IJeffray/IanS_ide_podule-16bit/PCB/README.md

# ide podule 16bit

These are the KiCad (version 8) files for the 16-bit ide podule.
