IJeffray/IanS_ide_podule-16bit/PCB/Altium/ide_podule-16bit_long_cf_backplate.STEP

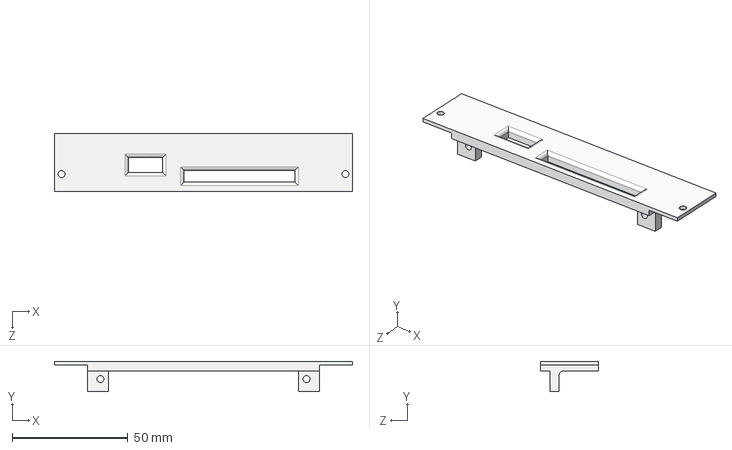
[picture p2: CAD file, 2026-10-07]
PCB/Altium/ide_podule-16bit_long_cf_backplate.STEP
128.6 x 13.1 x 25.0 mm
