IJeffray/IanS_ide_podule-16bit/(list of files, cad)

Other CAD files:
PCB/Altium/ide_podule-16bit_long_cf_backplate.SLDPRT
