IJeffray/IanS_ide_podule-16bit/Schematic.pdf

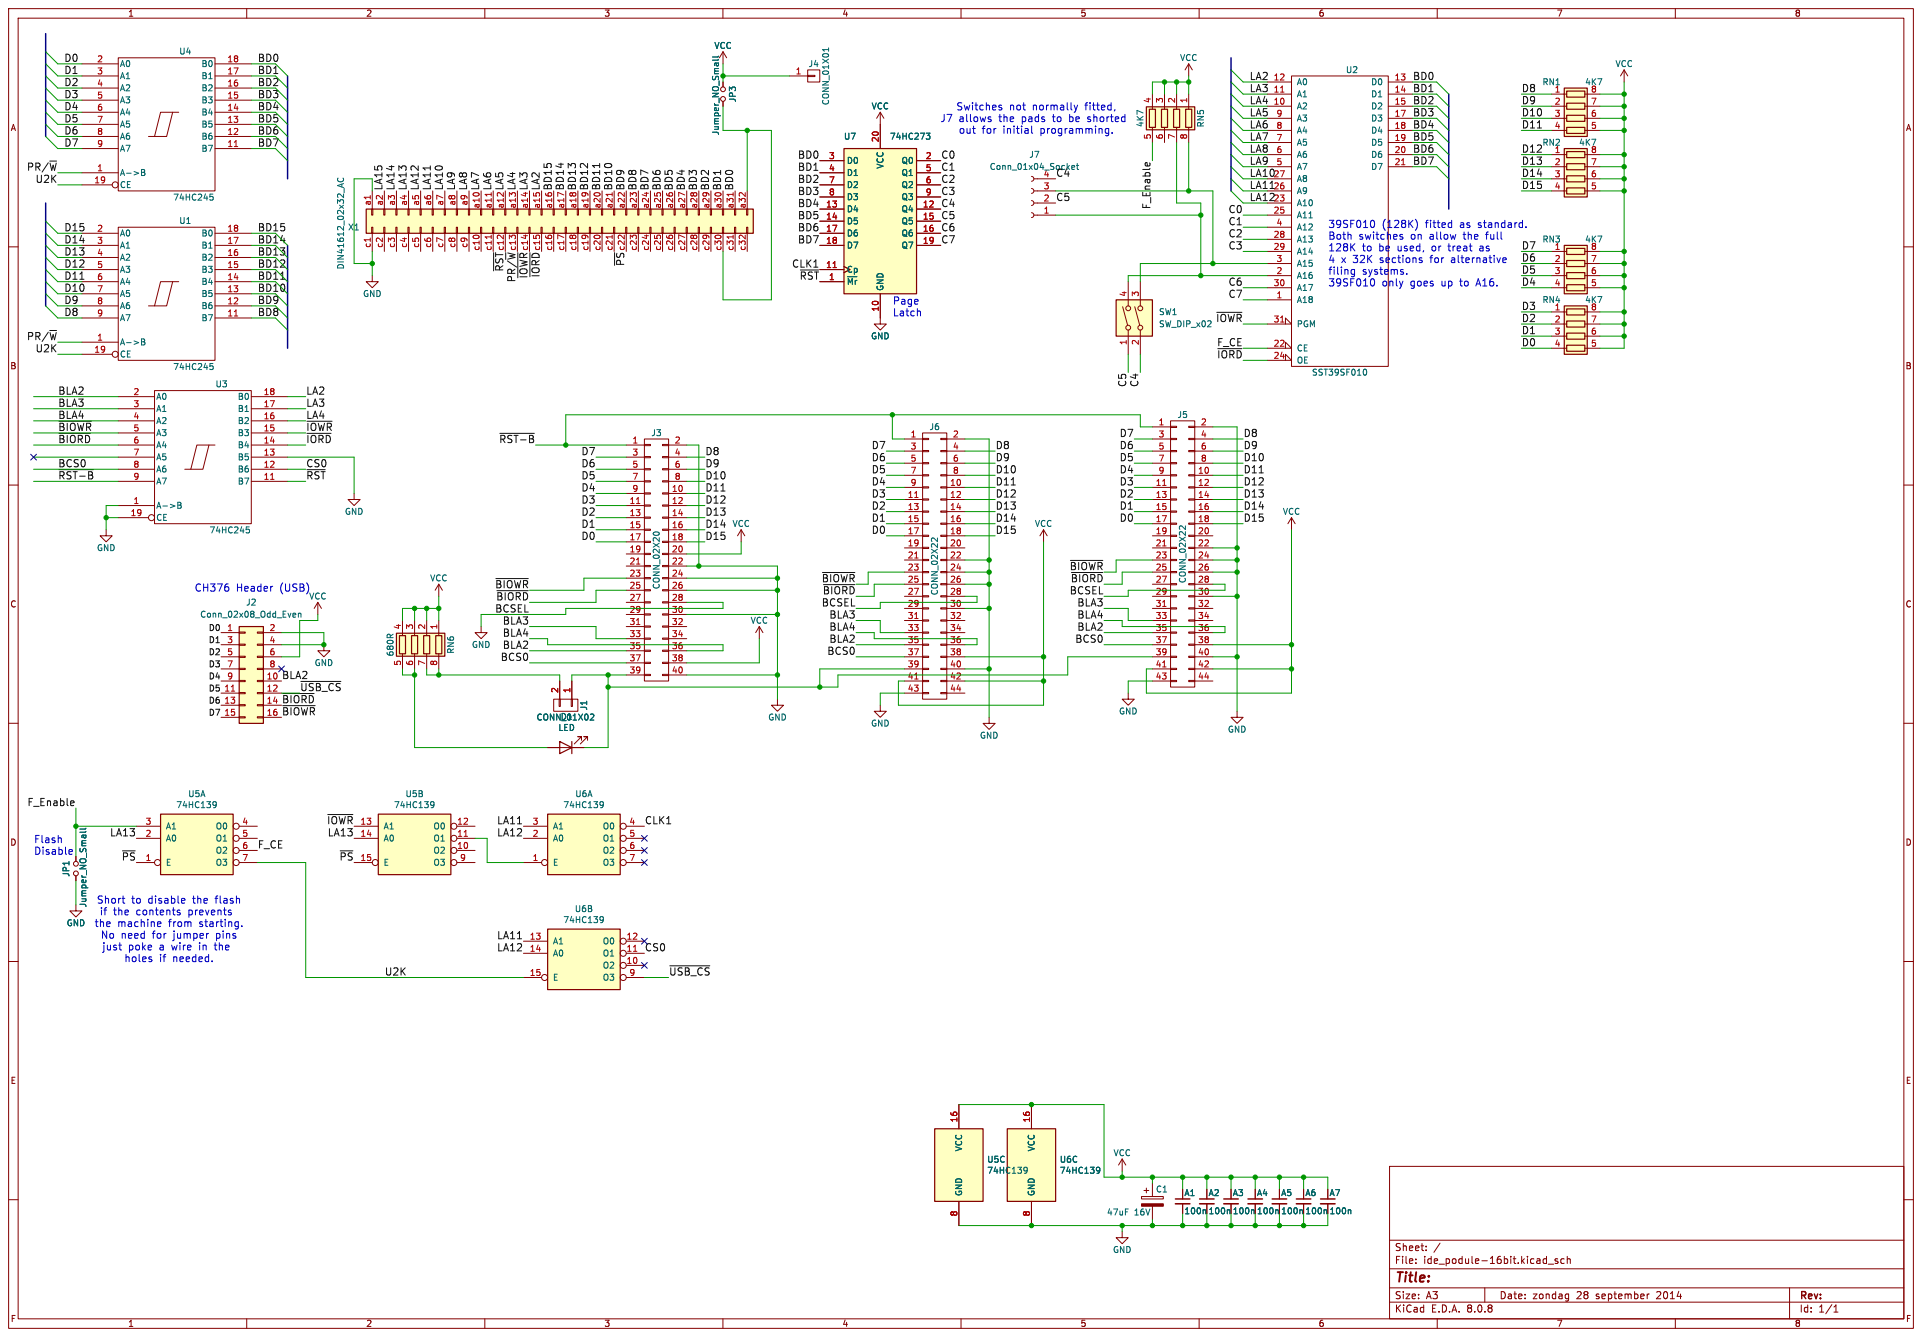
[picture p3: page 1]

39SF010 (128K) fitted as standard. Both switches on allow the full 128K to be used, or treat as 4 x 32K sections for alternative

Short to disable the flash
the machine from starting. No need for jumper pins

just poke a wire in the
holes if needed.

Id: 1/1 Title: File: ide_podule-16bit.kicad_sch Sheet: /
