IJeffray/IanS_ide_podule-16bit/(list of files, drawings)

Other design files:
PCB/Altium/ide_podule-16bit.PcbDoc
PCB/Altium/ide_podule-16bit.PrjPcb
PCB/Altium/ide_podule-16bit.SchDoc
PCB/Altium/ide_podule-16bit.SchLib
PCB/Altium/ide_podule-16bit_long.PcbDoc
