IJeffray/IanS_ide_podule-16bit/PCB/ide_podule-16bit.kicad_pcb

## KiCad design PCB/ide_podule-16bit.kicad_pcb (2026-04-19)

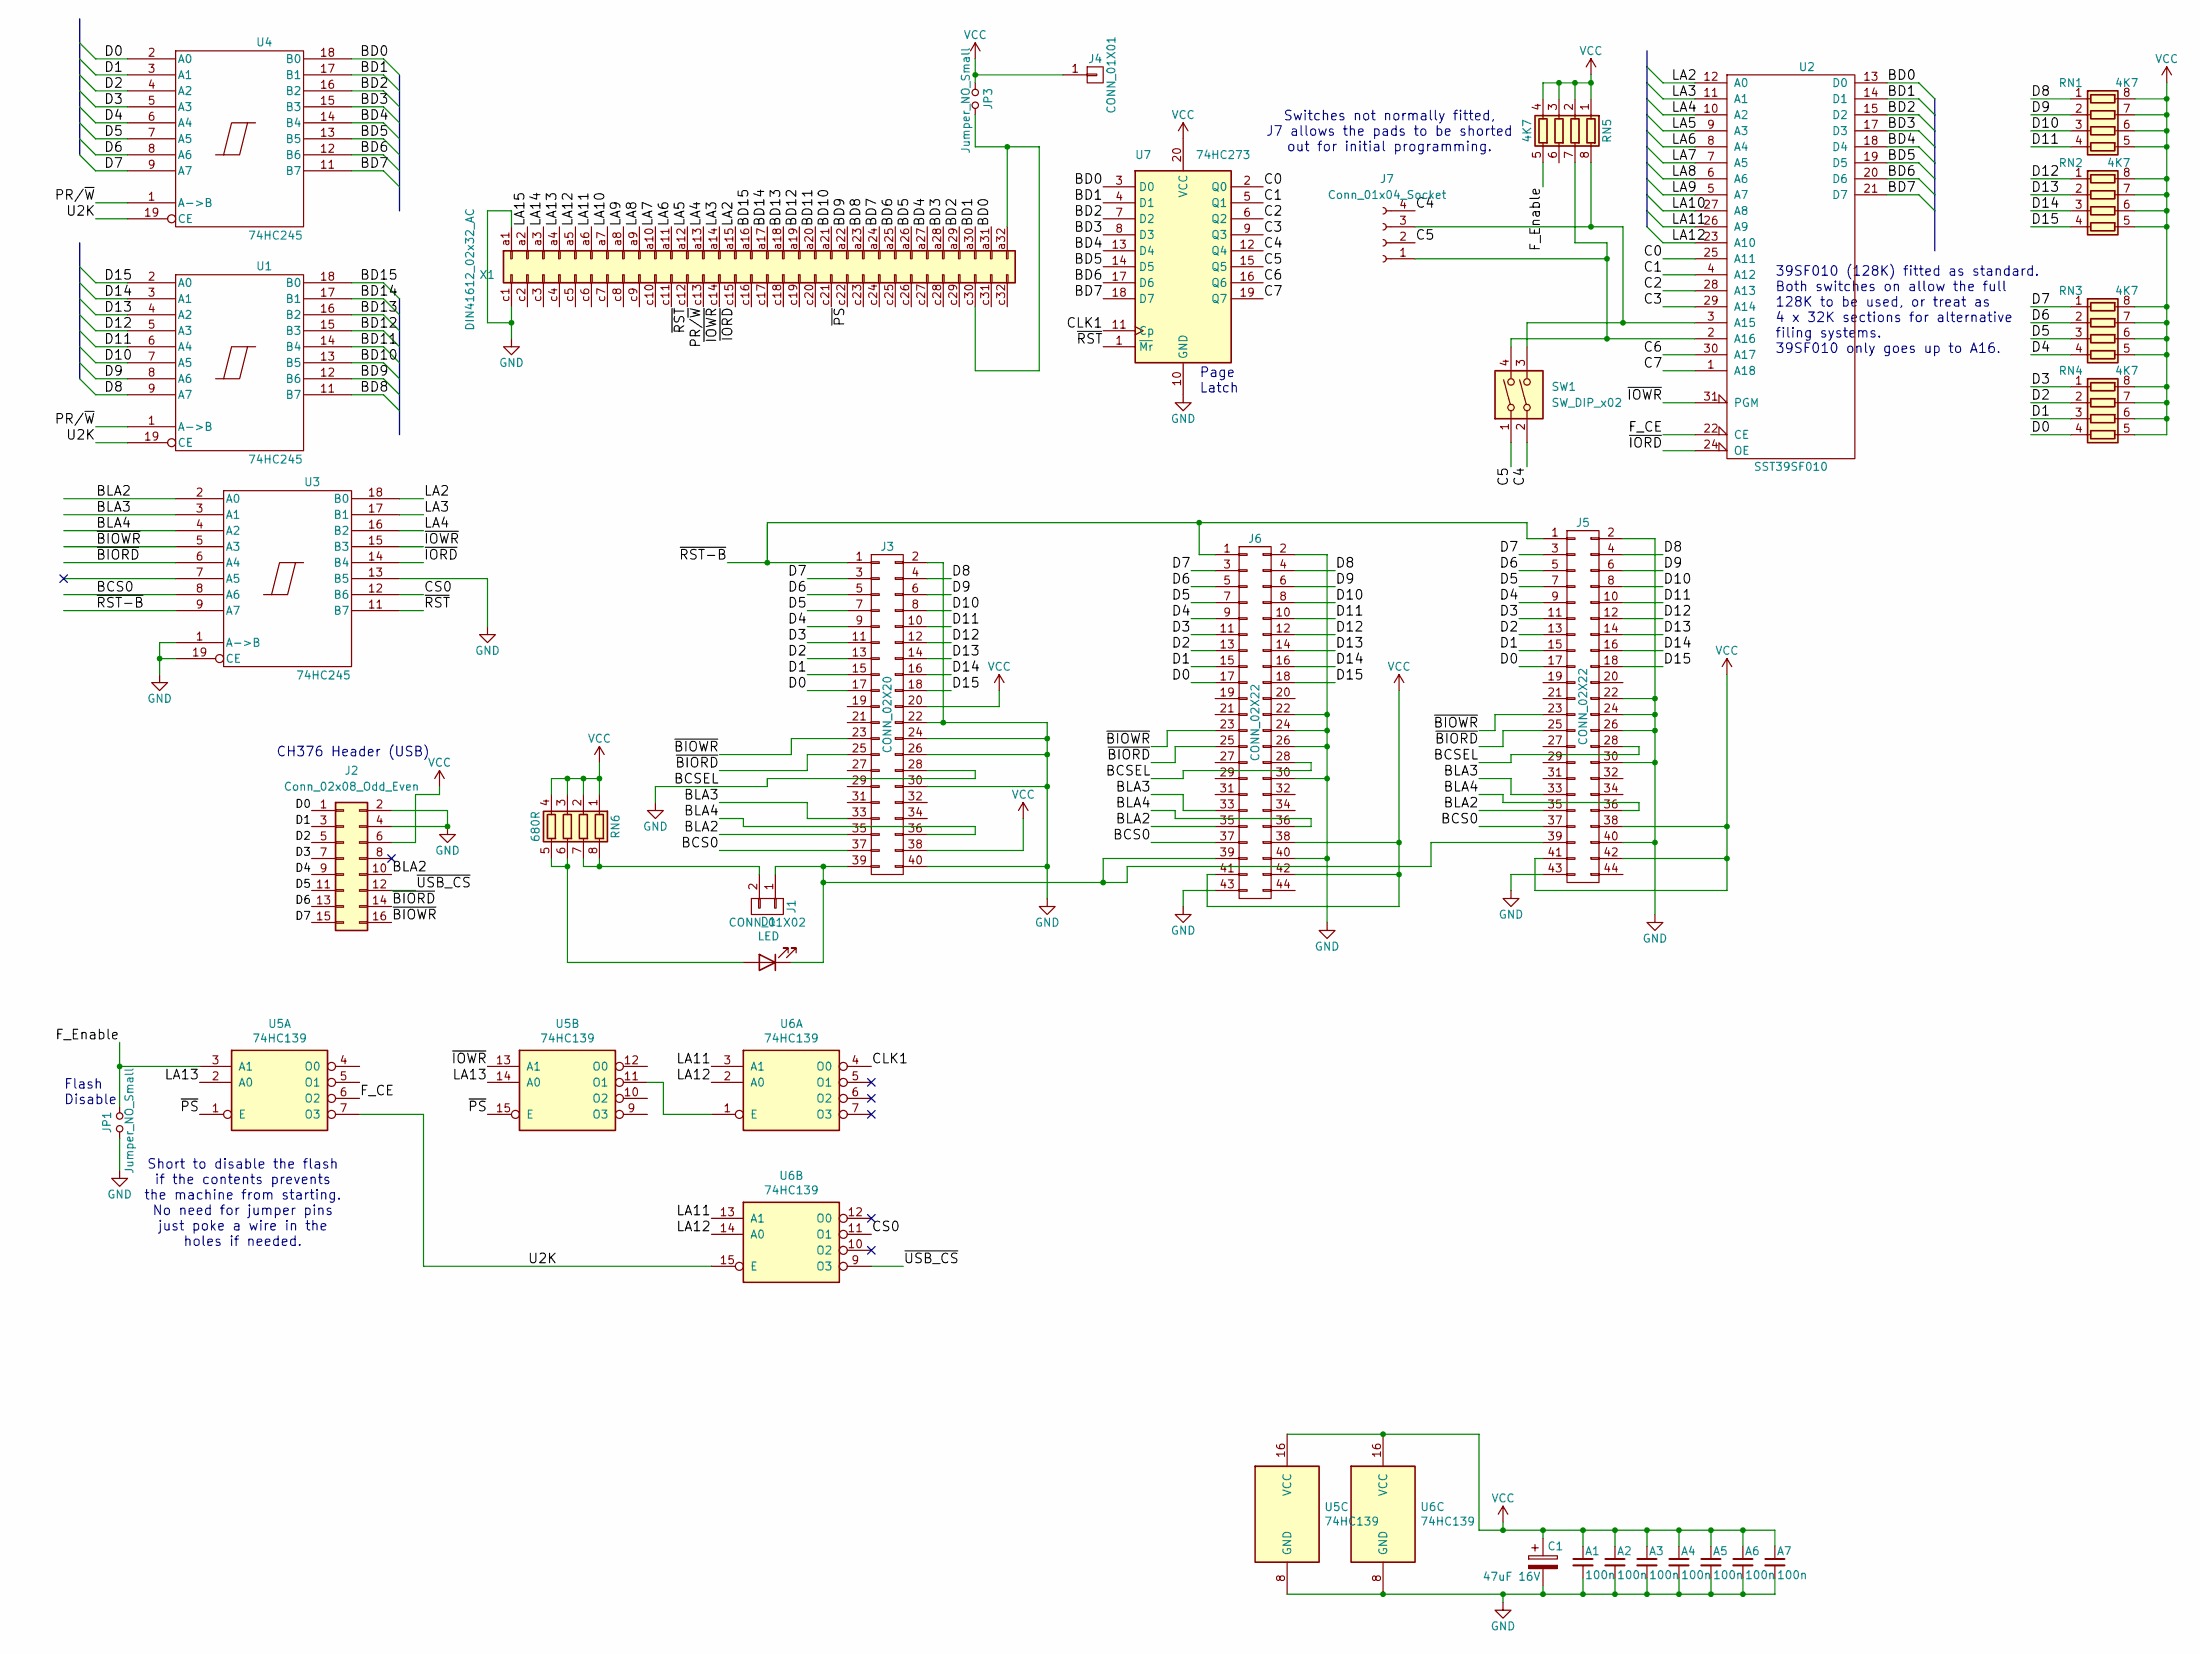
[picture p4: schematic ide_podule-16bit.kicad_sch]

Parts:
A1, A2, A3, A4, A5, A6, A7: 100n; C_1206_3216Metric_Pad1.33x1.80mm_HandSolder
C1: 47uF 16V; CP_Elec_6.3x5.8
D1: LED; LED_1206_3216Metric
J1: CONN_01X02; PinHeader_1x02_P2.54mm_Vertical
J2: Conn_02x08_Odd_Even; CH376-mod
J3: CONN_02X20; PinHeader_2x20_P2.54mm_Vertical
J4: CONN_01X01; SolderWirePad_2x_1-5mmDrill
J5: CONN_02X22; PinHeader_2x22_P2.00mm_Vertical
J6: CONN_02X22; IDE-edge-44pinC
J7: Conn_01x04_Socket; 4 way edge
JP1: Jumper_NO_Small; PinHeader_1x02_P2.54mm_Vertical
JP3: Jumper_NO_Small; PinHeader_2x01_P2.54mm_Vertical
RN1, RN2, RN3, RN4, RN5: 4K7; R_Array_Convex_4x0603
RN6: 680R; R_Array_Convex_4x0603
SW1: SW_DIP_x02; DIP-4_W7.62mm_Socket
U1, U3, U4: 74HC245; SOIC-20W_7.5x12.8mm_P1.27mm
U2: SST39SF010; PLCC-32_11.4x14.0mm_P1.27mm
U5, U6: 74HC139; STC_SOP-16_3.9x9.9mm_P1.27mm
U7: 74HC273; SOIC-20W_7.5x12.8mm_P1.27mm
X1: DIN41612_02x32_AC; DIN41612_C_2x32_Male_Horizontal_THT

Connections:
/BCS0: J3.37, J5.37, J6.37, U3.8 (A6)
/BD0: U2.13 (D0), U4.18 (B0), U7.3 (D0), X1.a31
/BD1: U2.14 (D1), U4.17 (B1), U7.4 (D1), X1.a30
/BD2: U2.15 (D2), U4.16 (B2), U7.7 (D2), X1.a29
/BD3: U2.17 (D3), U4.15 (B3), U7.8 (D3), X1.a28
/BD4: U2.18 (D4), U4.14 (B4), U7.13 (D4), X1.a27
/BD5: U2.19 (D5), U4.13 (B5), U7.14 (D5), X1.a26
/BD6: U2.20 (D6), U4.12 (B6), U7.17 (D6), X1.a25
/BD7: U2.21 (D7), U4.11 (B7), U7.18 (D7), X1.a24
/BD8: U1.11 (B7), X1.a23
/BD9: U1.12 (B6), X1.a22
/BD10: U1.13 (B5), X1.a21
/BD11: U1.14 (B4), X1.a20
/BD12: U1.15 (B3), X1.a19
/BD13: U1.16 (B2), X1.a18
/BD14: U1.17 (B1), X1.a17
/BD15: U1.18 (B0), X1.a16
/BLA2: J2.10, J3.35, J5.35, J6.35, U3.2 (A0)
/BLA3: J3.33, J5.33, J6.33, U3.3 (A1)
/BLA4: J3.36, J5.36, J6.36, U3.4 (A2)
/C0: U2.25 (A11), U7.2 (Q0)
/C1: U2.4 (A12), U7.5 (Q1)
/C2: U2.28 (A13), U7.6 (Q2)
/C3: U2.29 (A14), U7.9 (Q3)
/C4: J7.4, SW1.2, U7.12 (Q4)
/C5: J7.2, SW1.1, U7.15 (Q5)
/C6: U2.30 (A17), U7.16 (Q6)
/C7: U2.1 (A18), U7.19 (Q7)
/CLK1: U6.4 (O0), U7.11 (Cp)
/CS0: U3.12 (B6), U6.11 (O1)
/D0: J2.1, J3.17, J5.17, J6.17, RN4.4 (R4.1), U4.2 (A0)
/D1: J2.3, J3.15, J5.15, J6.15, RN4.3 (R3.1), U4.3 (A1)
/D2: J2.5, J3.13, J5.13, J6.13, RN4.2 (R2.1), U4.4 (A2)
/D3: J2.7, J3.11, J5.11, J6.11, RN4.1 (R1.1), U4.5 (A3)
/D4: J2.9, J3.9, J5.9, J6.9, RN3.4 (R4.1), U4.6 (A4)
/D5: J2.11, J3.7, J5.7, J6.7, RN3.3 (R3.1), U4.7 (A5)
/D6: J2.13, J3.5, J5.5, J6.5, RN3.2 (R2.1), U4.8 (A6)
/D7: J2.15, J3.3, J5.3, J6.3, RN3.1 (R1.1), U4.9 (A7)
/D8: J3.4, J5.4, J6.4, RN1.1 (R1.1), U1.9 (A7)
/D9: J3.6, J5.6, J6.6, RN1.2 (R2.1), U1.8 (A6)
/D10: J3.8, J5.8, J6.8, RN1.3 (R3.1), U1.7 (A5)
/D11: J3.10, J5.10, J6.10, RN1.4 (R4.1), U1.6 (A4)
/D12: J3.12, J5.12, J6.12, RN2.1 (R1.1), U1.5 (A3)
/D13: J3.14, J5.14, J6.14, RN2.2 (R2.1), U1.4 (A2)
/D14: J3.16, J5.16, J6.16, RN2.3 (R3.1), U1.3 (A1)
/D15: J3.18, J5.18, J6.18, RN2.4 (R4.1), U1.2 (A0)
/F_CE: U2.22 (CE), U5.6 (O2)
/F_Enable: JP1.2, RN5.5 (R4.2), U5.3 (A1)
/LA2: U2.12 (A0), U3.18 (B0), X1.a15
/LA3: U2.11 (A1), U3.17 (B1), X1.a14
/LA4: U2.10 (A2), U3.16 (B2), X1.a13
/LA5: U2.9 (A3), X1.a12
/LA6: U2.8 (A4), X1.a11
/LA7: U2.7 (A5), X1.a10
/LA8: U2.6 (A6), X1.a9
/LA9: U2.5 (A7), X1.a8
/LA10: U2.27 (A8), X1.a7
/LA11: U2.26 (A9), U6.3 (A1), U6.13 (A1), X1.a6
/LA12: U2.23 (A10), U6.2 (A0), U6.14 (A0), X1.a5
/LA13: U5.2 (A0), U5.14 (A0), X1.a4
/LA14: X1.a3
/LA15: X1.a2
/PR/~W: U1.1 (A->B), U4.1 (A->B), X1.c13
/U2K: U1.19 (CE), U4.19 (CE), U5.7 (O3), U6.15 (E)
/~BIORD: J2.14, J3.25, J5.25, J6.25, U3.6 (A4)
/~BIOWR: J2.16, J3.23, J5.23, J6.23, U3.5 (A3)
/~IORD: U2.24 (OE), U3.14 (B4), X1.c15
/~IOWR: U2.31 (PGM), U3.15 (B3), U5.13 (A1), X1.c14
/~PS: U5.1 (E), U5.15 (E), X1.c22
/~RST-B: J3.1, J5.1, J6.1, U3.9 (A7)
/~RST: U3.11 (B7), U7.1 (~Mr), X1.c12
/~USB_CS: J2.12, U6.9 (O3)
GND: A1.2, A2.2, A3.2, A4.2, A5.2, A6.2, A7.2, C1.2, J2.2, J2.4, J3.2, J3.22, J3.24, J3.26, J3.28, J3.30, J3.40, J5.2, J5.22, J5.24, J5.26, J5.28, J5.30, J5.40, J5.43, J6.2, J6.22, J6.24, J6.26, J6.28, J6.30, J6.40, J6.43, JP1.1, U1.10 (GND), U2.16 (GND), U3.1 (A->B), U3.10 (GND), U3.13 (B5), U3.19 (CE), U4.10 (GND), U5.8 (GND), U6.8 (GND), U7.10 (GND), X1.a1, X1.c1
unnamed: D1.2 (A), RN6.5 (R4.2), RN6.6 (R3.2)
unnamed: D1.1 (K), J1.1, J3.39, J5.39, J6.39
unnamed: J1.2, RN6.7 (R2.2), RN6.8 (R1.2)
unnamed: J7.1, RN5.7 (R2.2), SW1.4, U2.2 (A16)
unnamed: J7.3, RN5.8 (R1.2), SW1.3, U2.3 (A15)
unnamed: U5.11 (O1), U6.1 (E)
unnamed: JP3.2, X1.a32, X1.c30
VCC: A1.1, A2.1, A3.1, A4.1, A5.1, A6.1, A7.1, C1.1, J2.6, J3.20, J3.38, J4.1, J5.38, J5.41, J5.42, J6.38, J6.41, J6.42, JP3.1, RN1.5 (R4.2), RN1.6 (R3.2), RN1.7 (R2.2), RN1.8 (R1.2), RN2.5 (R4.2), RN2.6 (R3.2), RN2.7 (R2.2), RN2.8 (R1.2), RN3.5 (R4.2), RN3.6 (R3.2), RN3.7 (R2.2), RN3.8 (R1.2), RN4.5 (R4.2), RN4.6 (R3.2), RN4.7 (R2.2), RN4.8 (R1.2), RN5.1 (R1.1), RN5.2 (R2.1), RN5.3 (R3.1), RN5.4 (R4.1), RN6.1 (R1.1), RN6.2 (R2.1), RN6.3 (R3.1), RN6.4 (R4.1), U1.20 (VCC), U2.32 (VCC), U3.20 (VCC), U4.20 (VCC), U5.16 (VCC), U6.16 (VCC), U7.20 (VCC)

Notes on the sheet:
Short to disable the flash if the contents prevents the machine from starting. No need for jumper pins just poke a wire in the holes if needed.
39SF010 (128K) fitted as standard. Both switches on allow the full 128K to be used, or treat as 4 x 32K sections for alternative filing systems. 39SF010 only goes up to A16.
Page Latch
CH376 Header (USB)
Flash Disable
Switches not normally fitted, J7 allows the pads to be shorted out for initial programming.

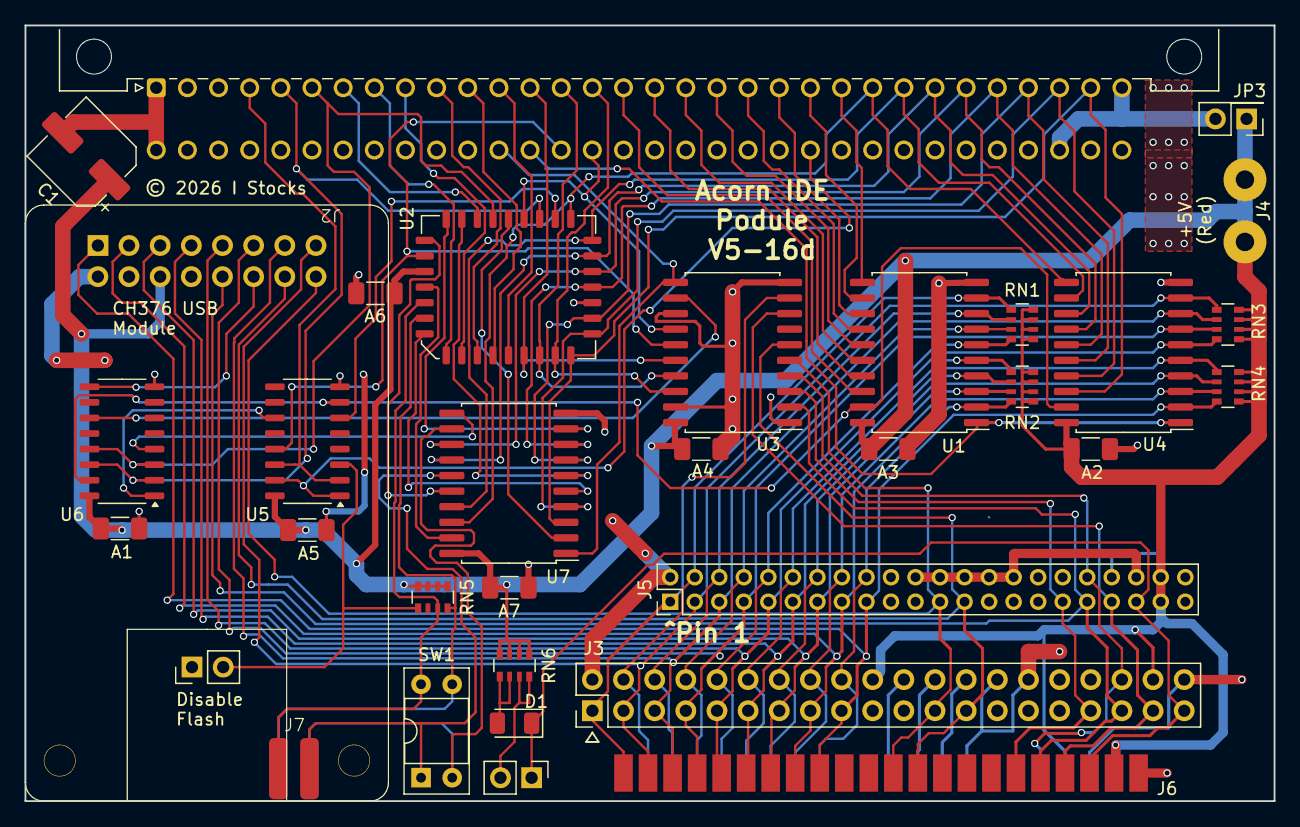
[picture p5: board ide_podule-16bit.kicad_pcb from above]

Board: 2 copper layers, 101.9 x 63.2 mm, 33 parts (0 on the bottom side), 79 nets.
