IJeffray/IanS_ide_podule-16bit/(commit log)

2026-04-19 initial version
    [ide_podule-16bit.kicad_pcb, ide_podule-16bit.kicad_sch]
2026-10-07 Full length podule version, in Altium, with CF card support.
    [ide_podule-16bit.PcbDoc, ide_podule-16bit.PrjPcb, ide_podule-16bit.SchDoc, ide_podule-16bit.SchLib, ide_podule-16bit_long.PcbDoc]
2026-10-07 Rename folder
    [ide_podule-16bit.PcbDoc, ide_podule-16bit.PrjPcb, ide_podule-16bit.SchDoc, ide_podule-16bit.SchLib, ide_podule-16bit_long.PcbDoc]
2026-10-07 Add 3D model for backplate and pull it in to the PCB CAD.
    [ide_podule-16bit_long.PcbDoc, ide_podule-16bit_long_cf_backplate.SLDPRT, ide_podule-16bit_long_cf_backplate.STEP]
2026-10-08 Change to 0805 caps
    [ide_podule-16bit.PrjPcb, ide_podule-16bit.SchDoc, ide_podule-16bit_long.PcbDoc]
