IJeffray/IanS_ide_podule-16bit/(notices)

Notices in the files:
PCB/ide_podule-16bit.kicad_pcb:
© 2026 I Stocks
